hansench-bit/meshslide-dualrf/renders/2D_Fitment_Check_v2.0.png

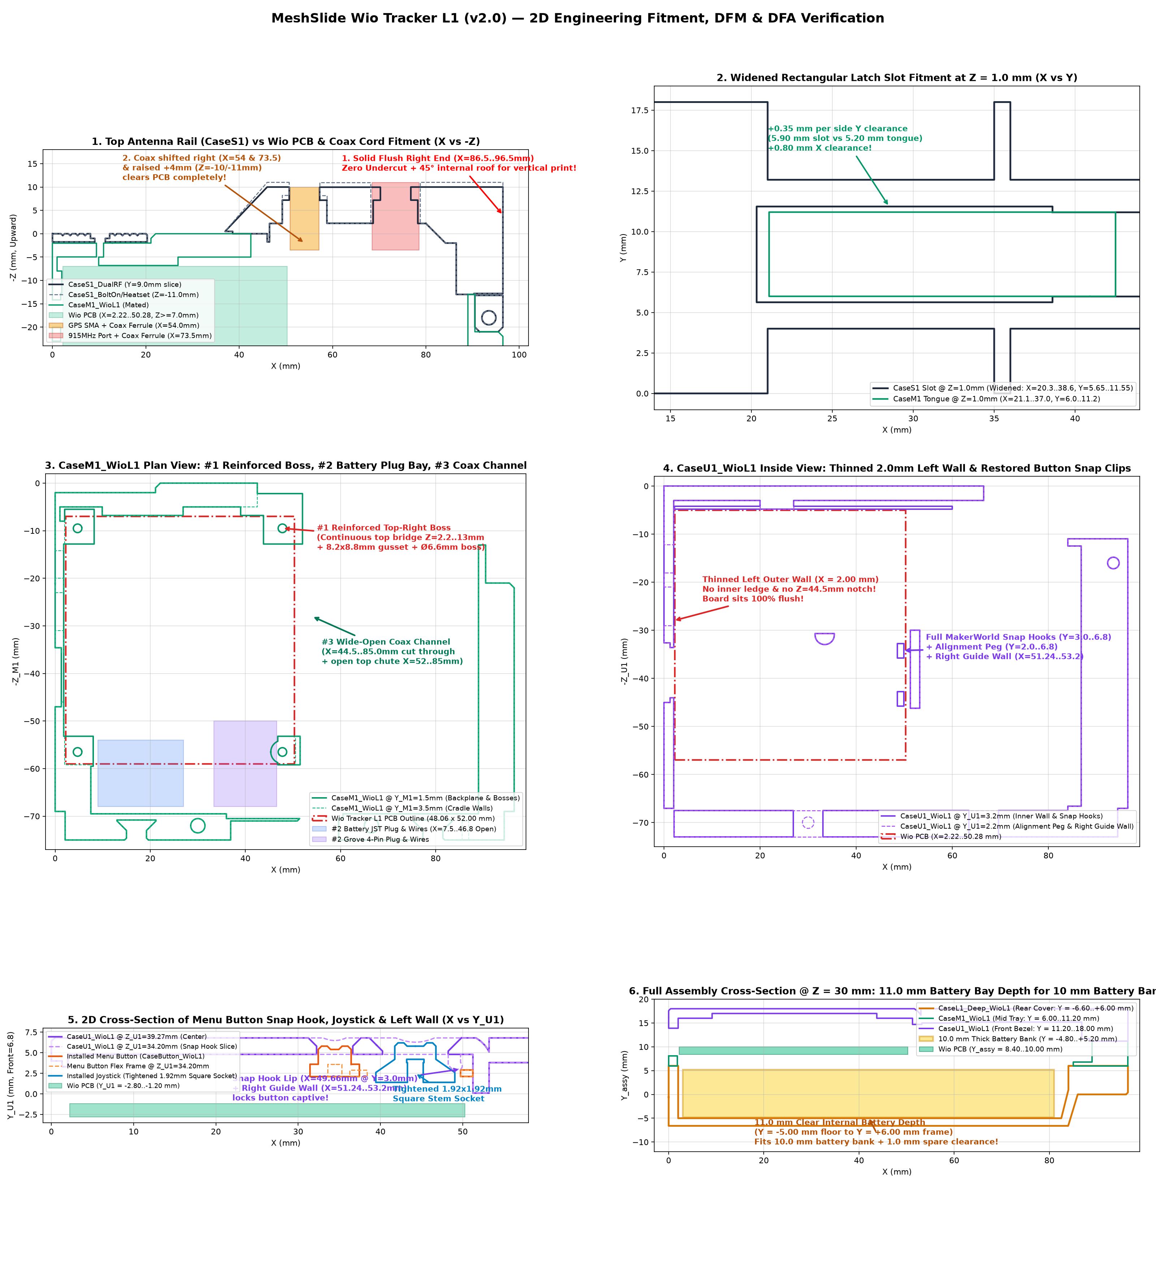
renders/2D_Fitment_Check_v2.0.png
