hansench-bit/meshslide-dualrf/renders/CaseS1_DualRF_BoltOn_Underside_Check.png

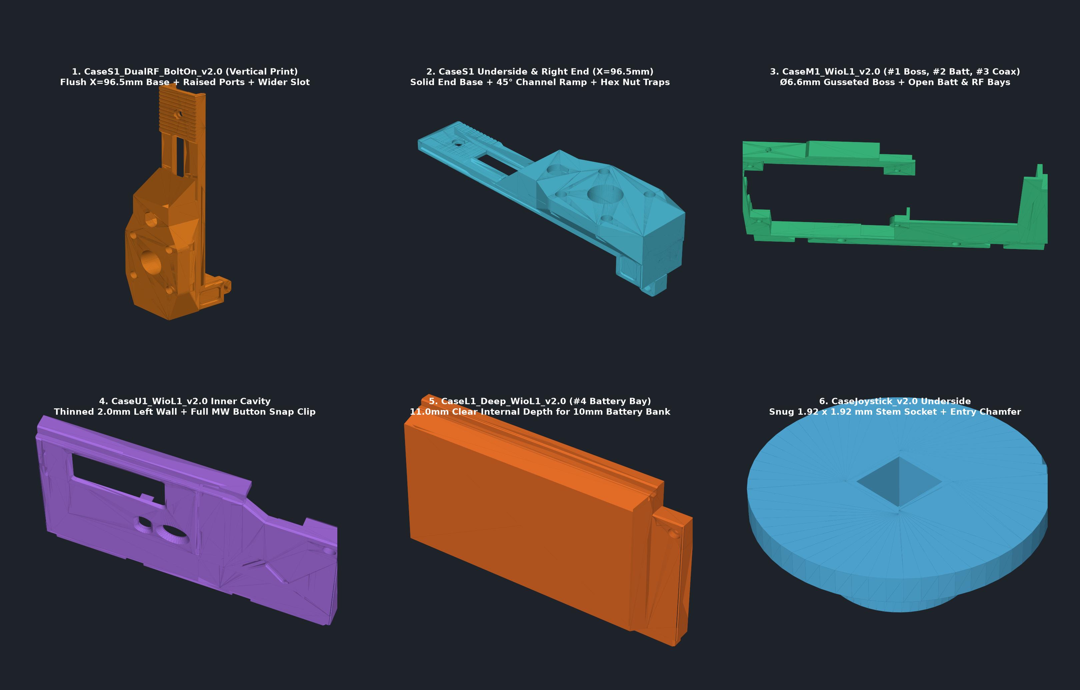
renders/CaseS1_DualRF_BoltOn_Underside_Check.png
