hansench-bit/meshslide-dualrf/renders/MeshSlide_DualRF_Blueprints.png

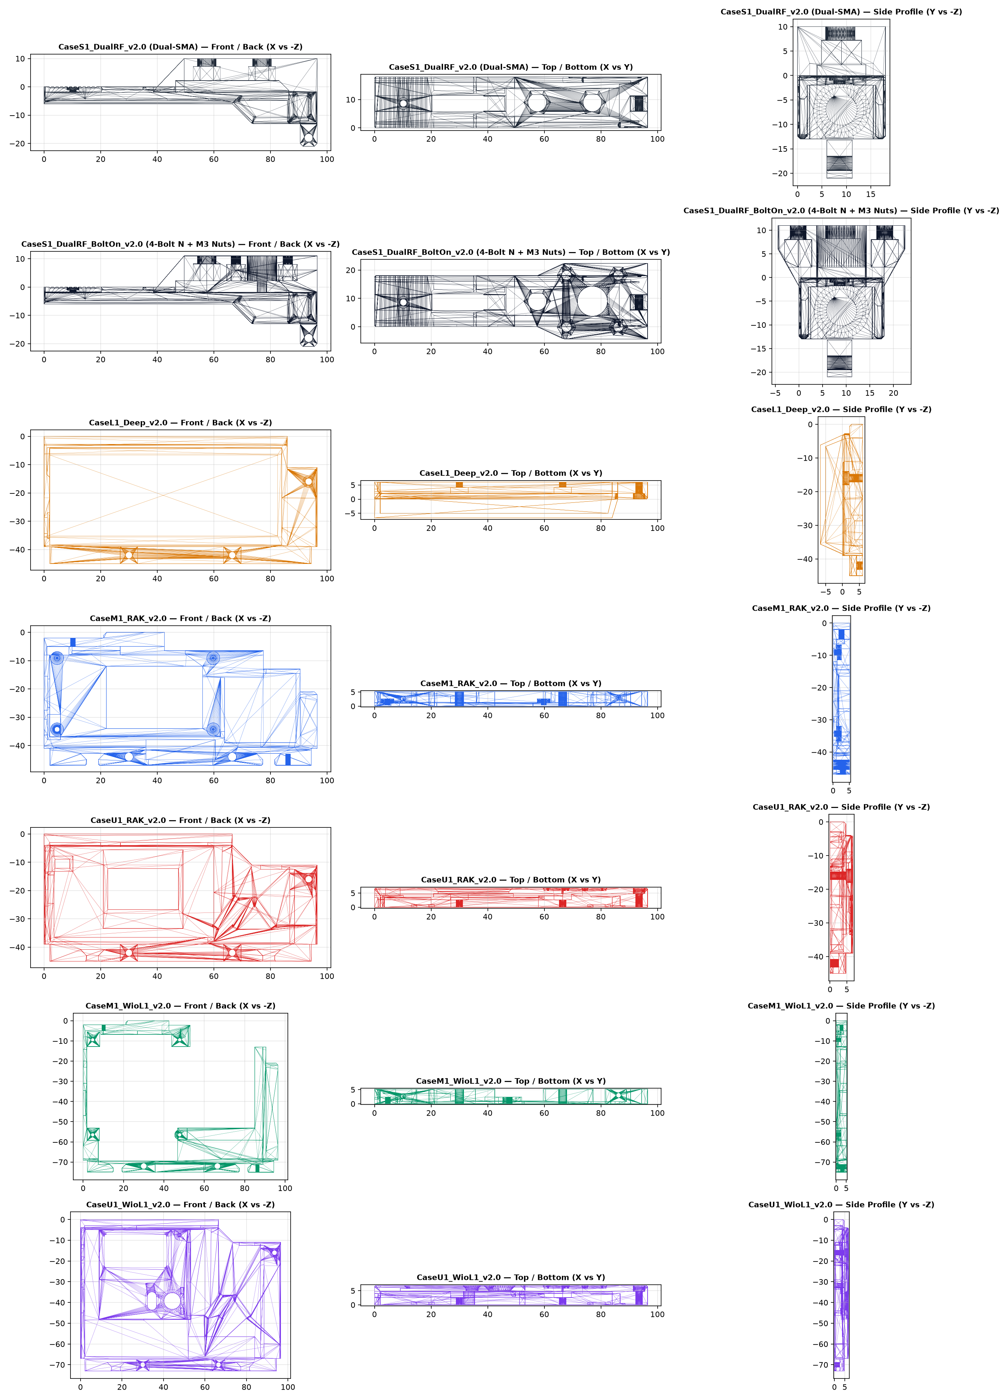
renders/MeshSlide_DualRF_Blueprints.png
