hansench-bit/meshslide-dualrf/renders/Top_Antenna_Rails_v2.0.png

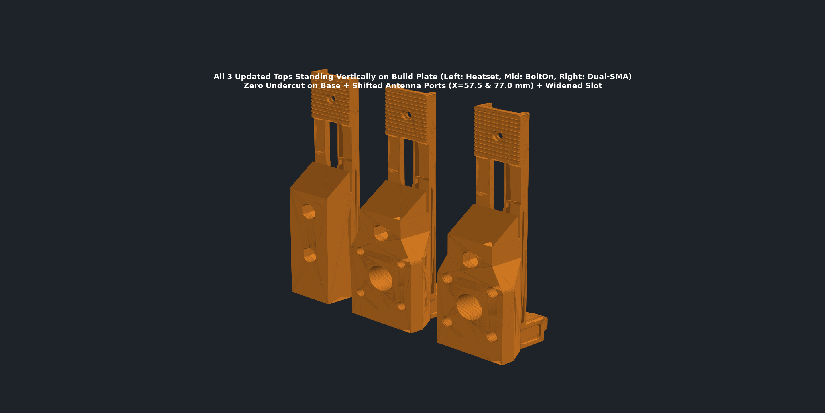
renders/Top_Antenna_Rails_v2.0.png
