hansench-bit/meshslide-dualrf/3MF/Wio_Tracker_L1_Complete_v2.0.3mf

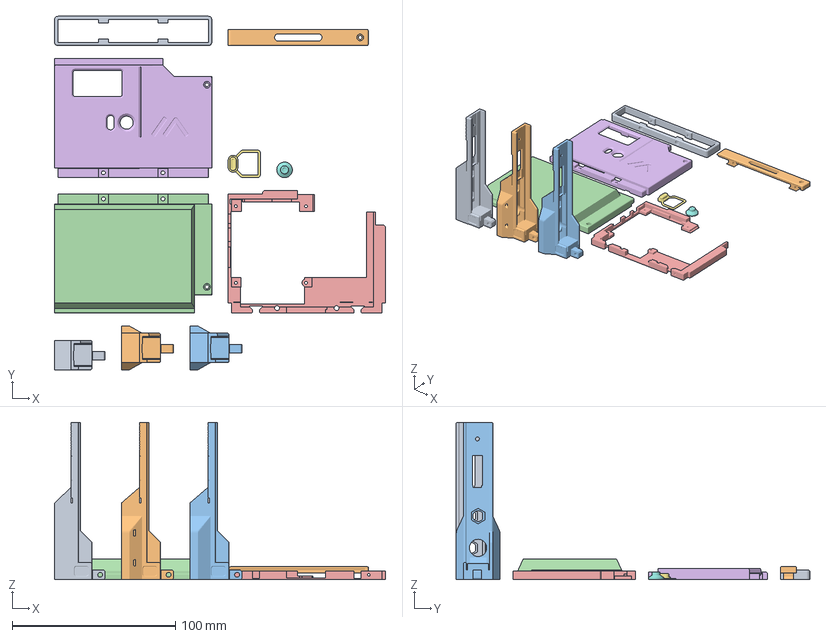
[picture p15: CAD file, 2026-11-10]
3MF/Wio_Tracker_L1_Complete_v2.0.3mf
203.0 x 216.8 x 96.5 mm
CaseS1_DualRF_v2.0
CaseS1_DualRF_BoltOn_v2.0
CaseS1_DualRF_Heatset_v2.0
CaseL1_Deep_WioL1_v2.0
CaseM1_WioL1_v2.0
CaseU1_WioL1_v2.0
CaseButton_WioL1_v2.0
CaseJoystick_v2.0
CaseR1_v2.0
CaseSlide_v2.0
