hansench-bit/meshslide-dualrf/reference_original/Wio_MW_Bezel_Patch.stl

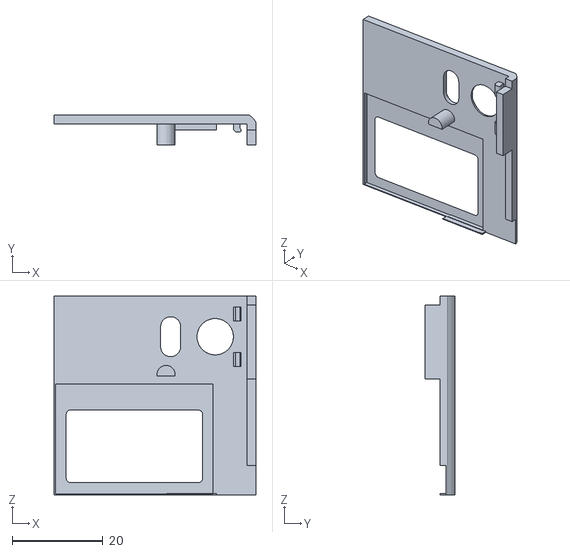
[picture p16: CAD file, 2026-11-10]
reference_original/Wio_MW_Bezel_Patch.stl
44.4 x 6.70 x 43.7
