hansench-bit/meshslide-dualrf/reference_original/CaseM1.STL

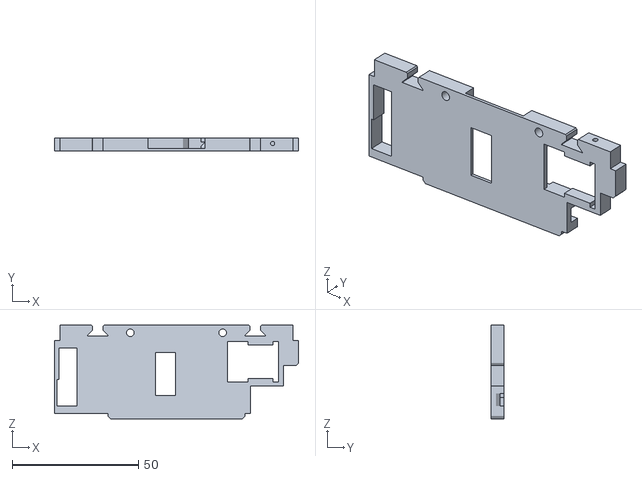
[picture p17: CAD file, 2026-11-09]
reference_original/CaseM1.STL
96.5 x 5.20 x 37.0
