hansench-bit/meshslide-dualrf/reference_original/CaseR1.STL

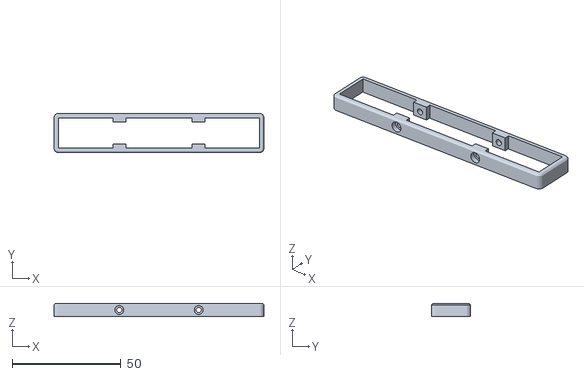
[picture p18: CAD file, 2026-11-09]
reference_original/CaseR1.STL
96.5 x 18.0 x 6.00
