hansench-bit/meshslide-dualrf/reference_original/KB_S3.STL

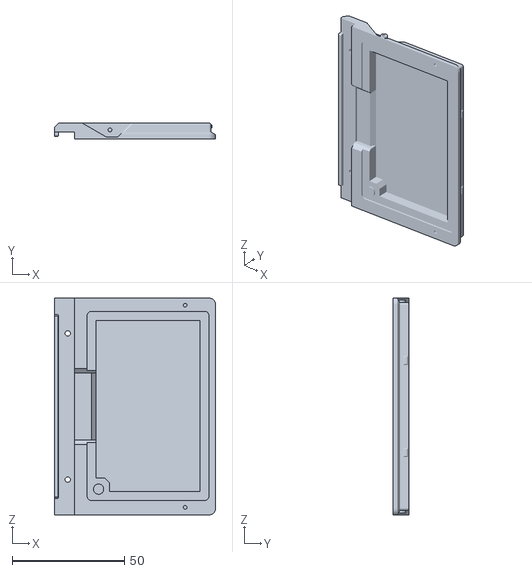
[picture p19: CAD file, 2026-11-09]
reference_original/KB_S3.STL
71.8 x 7.00 x 96.5
