hansench-bit/meshslide-dualrf/reference_original/Wio_MW_Menu_Button.stl

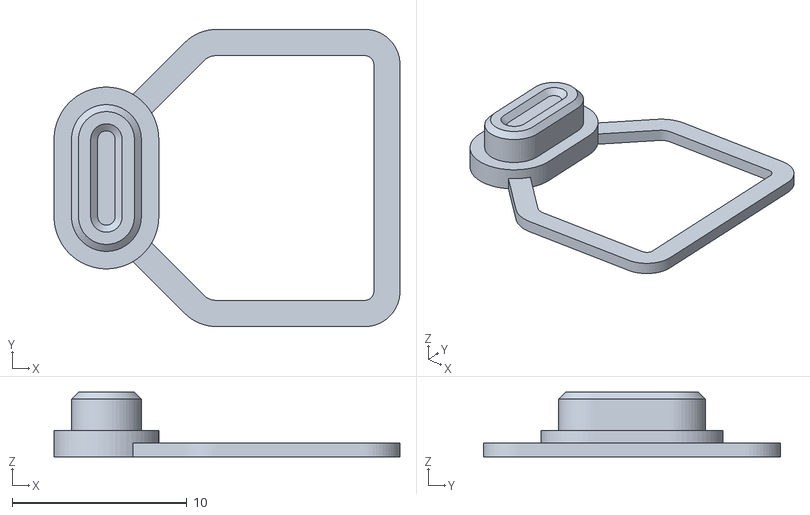
[picture p20: CAD file, 2026-11-09]
reference_original/Wio_MW_Menu_Button.stl
19.8 x 17.0 x 3.70
