hansench-bit/meshslide-dualrf/reference_original/Wio_MW_Joystick_Cap.stl

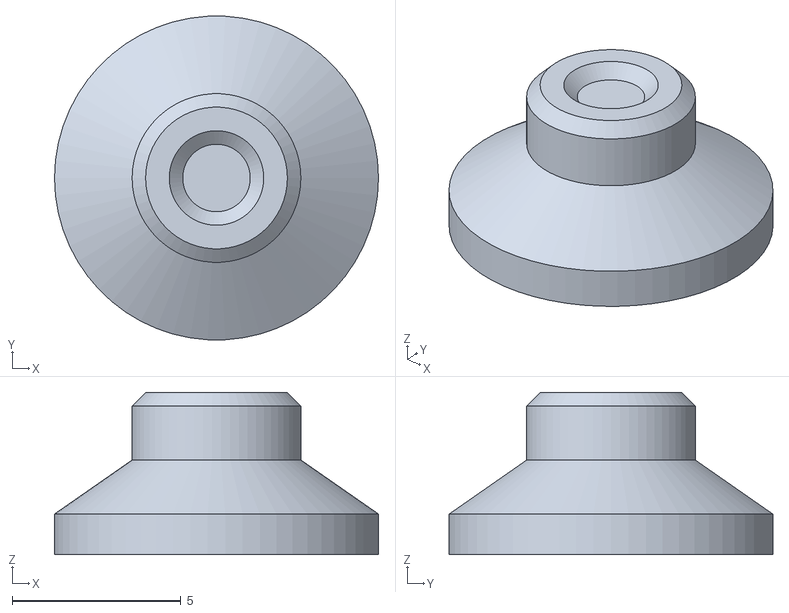
[picture p21: CAD file, 2026-11-09]
reference_original/Wio_MW_Joystick_Cap.stl
9.60 x 9.59 x 4.80
