hansench-bit/meshslide-dualrf/reference_original/KB_S1.STL

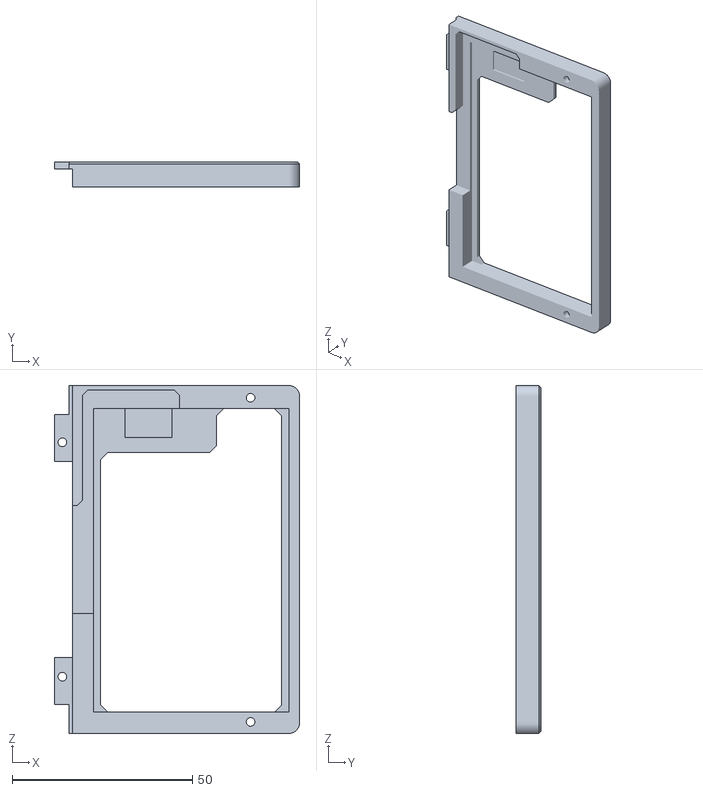
[picture p22: CAD file, 2026-11-09]
reference_original/KB_S1.STL
68.0 x 7.00 x 96.5
