hansench-bit/meshslide-dualrf/reference_original/CaseSlide.STL

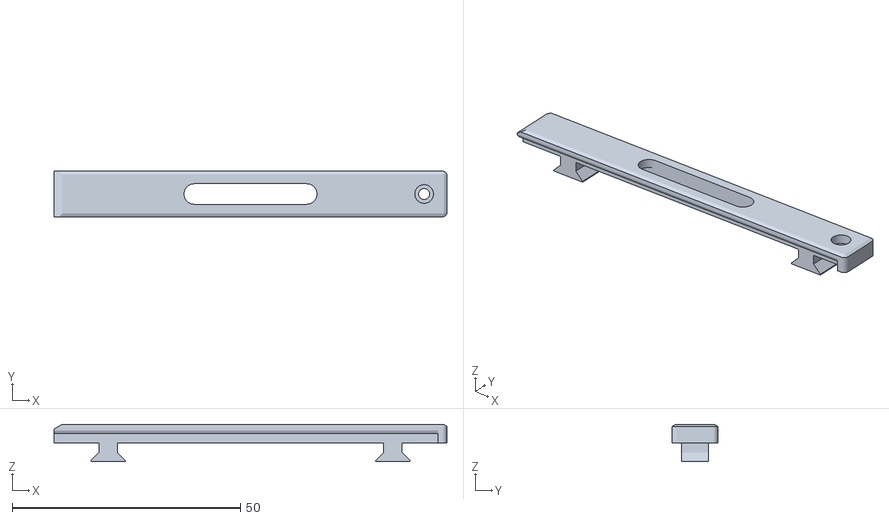
[picture p23: CAD file, 2026-11-09]
reference_original/CaseSlide.STL
86.0 x 10.0 x 8.10
