hansench-bit/meshslide-dualrf/reference_original/CaseL1.STL

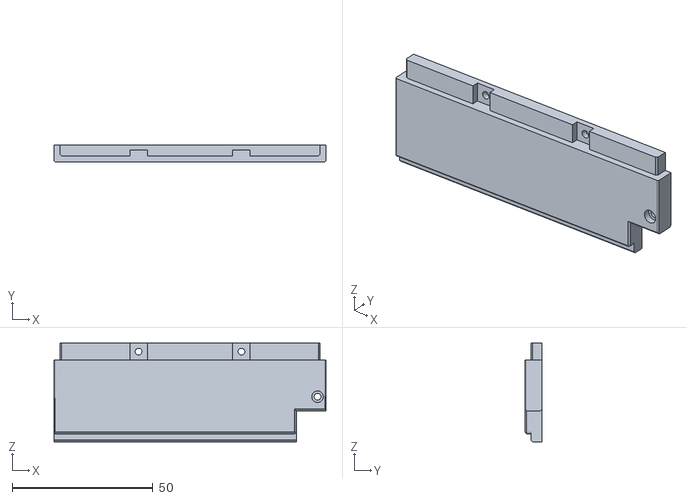
[picture p24: CAD file, 2026-11-09]
reference_original/CaseL1.STL
96.5 x 6.00 x 35.0
