hansench-bit/meshslide-dualrf/reference_original/CaseS1.STL

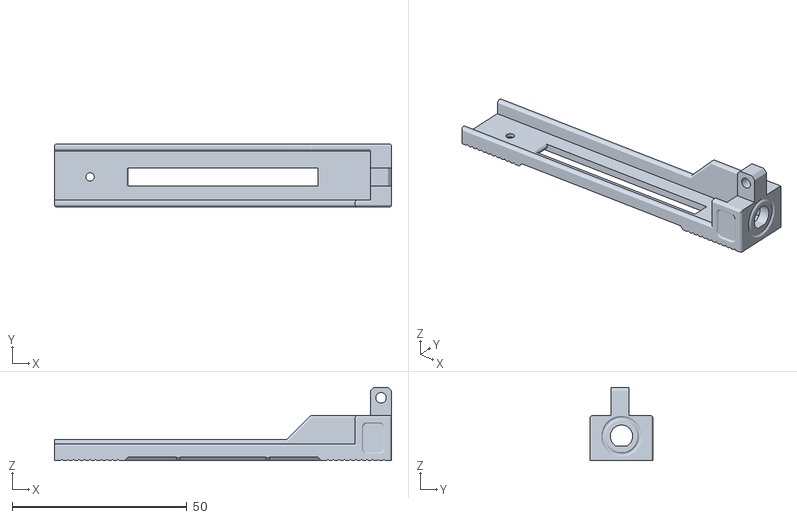
[picture p25: CAD file, 2026-11-09]
reference_original/CaseS1.STL
96.5 x 18.0 x 21.0
