hansench-bit/meshslide-dualrf/reference_original/CaseU1.STL

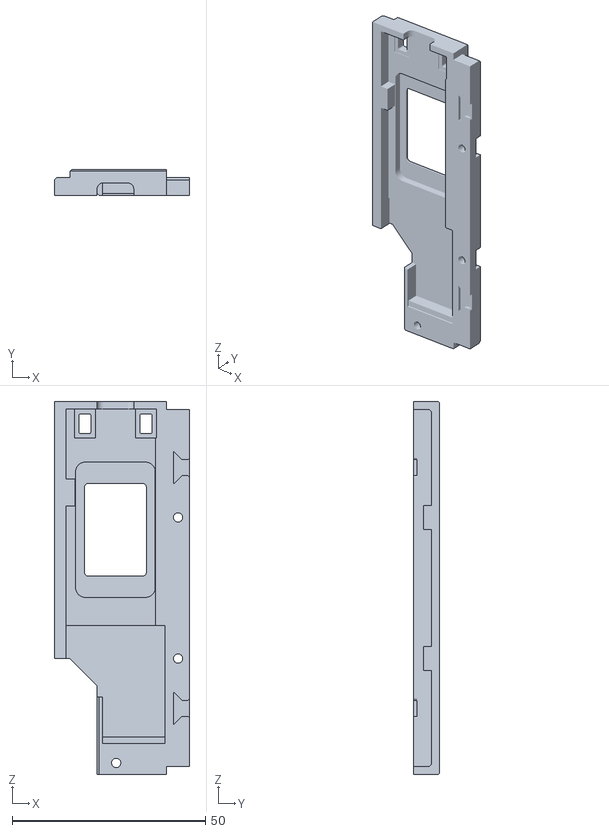
[picture p26: CAD file, 2026-11-09]
reference_original/CaseU1.STL
35.0 x 6.80 x 96.5
