hansench-bit/meshslide-dualrf/reference_original/CaseButton.STL

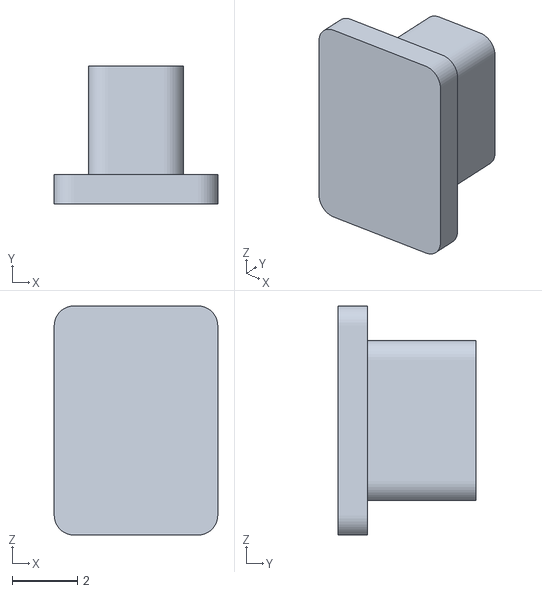
[picture p27: CAD file, 2026-11-09]
reference_original/CaseButton.STL
5.00 x 4.22 x 7.00
