hansench-bit/meshslide-dualrf/(list of files, cad)

Other CAD files:
STEP/CardKB_Pro_v2.0/KB_Button_Single_Main_v2.0.step
STEP/RAK_WisBlock_v2.0/CaseM1_RAK_v2.0.step
STEP/Wio_Tracker_L1_v2.0/CaseM1_WioL1_v2.0.step
STEP/CardKB_Pro_v2.0/KB_S1_Pro_v2.0.step
STEP/RAK_WisBlock_v2.0/CaseS1_DualRF_Heatset_v2.0.step
STEP/Wio_Tracker_L1_v2.0/CaseS1_DualRF_v2.0.step
STEP/CardKB_Pro_v2.0/CardKB_Standalone_Bezel_v2.0.step
STEP/Wio_Tracker_L1_v2.0/CaseS1_DualRF_Heatset_v2.0.step
STEP/CardKB_Pro_v2.0/KB_Buttons_Loose_Set_v2.0.step
STEP/RAK_WisBlock_v2.0/CaseS1_DualRF_v2.0.step
STEP/CardKB_Pro_v2.0/KB_S3_Pro_v2.0.step
STEP/RAK_WisBlock_v2.0/CaseL1_Deep_v2.0.step
STEP/Wio_Tracker_L1_v2.0/CaseL1_Deep_WioL1_v2.0.step
STEP/CardKB_Pro_v2.0/KB_Bezel_Legends_AMS_v2.0.step
STEP/RAK_WisBlock_v2.0/CaseButton_v2.0.step
STEP/Wio_Tracker_L1_v2.0/CaseJoystick_v2.0.step
STEP/CardKB_Pro_v2.0/KB_Buttons_Bridged_Tray_v2.0.step
STEP/RAK_WisBlock_v2.0/CaseU1_RAK_v2.0.step
STEP/Wio_Tracker_L1_v2.0/CaseU1_WioL1_v2.0.step
STEP/CardKB_Pro_v2.0/CardKB_Standalone_Back_v2.0.step
STEP/RAK_WisBlock_v2.0/CaseSlide_v2.0.step
STEP/Wio_Tracker_L1_v2.0/CaseButton_WioL1_v2.0.step
STEP/CardKB_Pro_v2.0/KB_TPU_Mat_v2.0.step
STEP/RAK_WisBlock_v2.0/CaseR1_v2.0.step
STEP/Wio_Tracker_L1_v2.0/CaseSlide_v2.0.step
STEP/Wio_Tracker_L1_v2.0/CaseR1_v2.0.step
STEP/RAK_WisBlock_v2.0/CaseS1_DualRF_BoltOn_v2.0.step
STEP/Wio_Tracker_L1_v2.0/CaseS1_DualRF_BoltOn_v2.0.step
STL/CardKB_Pro_v2.0/CardKB_Standalone_Back_v2.0.stl
STL/CardKB_Pro_v2.0/CardKB_Standalone_Bezel_v2.0.stl
STL/CardKB_Pro_v2.0/KB_Bezel_Legends_AMS_v2.0.stl
STL/CardKB_Pro_v2.0/KB_Button_Single_Main_v2.0.stl
STL/CardKB_Pro_v2.0/KB_Buttons_Bridged_Tray_v2.0.stl
STL/CardKB_Pro_v2.0/KB_Buttons_Loose_Set_v2.0.stl
STL/CardKB_Pro_v2.0/KB_S1_Pro_v2.0.stl
STL/CardKB_Pro_v2.0/KB_S3_Pro_v2.0.stl
STL/CardKB_Pro_v2.0/KB_TPU_Mat_v2.0.stl
STL/RAK_WisBlock_v2.0/CaseButton_v2.0.stl
STL/RAK_WisBlock_v2.0/CaseL1_Deep_v2.0.stl
STL/RAK_WisBlock_v2.0/CaseM1_RAK_v2.0.stl
STL/RAK_WisBlock_v2.0/CaseR1_v2.0.stl
STL/RAK_WisBlock_v2.0/CaseS1_DualRF_BoltOn_v2.0.stl
STL/RAK_WisBlock_v2.0/CaseS1_DualRF_Heatset_v2.0.stl
STL/RAK_WisBlock_v2.0/CaseS1_DualRF_v2.0.stl
STL/RAK_WisBlock_v2.0/CaseSlide_v2.0.stl
STL/RAK_WisBlock_v2.0/CaseU1_RAK_v2.0.stl
STL/Wio_Tracker_L1_v2.0/CaseButton_WioL1_v2.0.stl
STL/Wio_Tracker_L1_v2.0/CaseJoystick_v2.0.stl
STL/Wio_Tracker_L1_v2.0/CaseL1_Deep_WioL1_v2.0.stl
STL/Wio_Tracker_L1_v2.0/CaseM1_WioL1_v2.0.stl
STL/Wio_Tracker_L1_v2.0/CaseR1_v2.0.stl
STL/Wio_Tracker_L1_v2.0/CaseS1_DualRF_BoltOn_v2.0.stl
STL/Wio_Tracker_L1_v2.0/CaseS1_DualRF_Heatset_v2.0.stl
STL/Wio_Tracker_L1_v2.0/CaseS1_DualRF_v2.0.stl
STL/Wio_Tracker_L1_v2.0/CaseSlide_v2.0.stl
STL/Wio_Tracker_L1_v2.0/CaseU1_WioL1_v2.0.stl
