hansench-bit/meshslide-dualrf/(commit log)

2026-11-09 Release v2.0: Wio Tracker L1 & RAK19007 enclosures with Dual-SMA, Captive M3 Nut N-Type, and Heat-Set Insert N-Type top rails
    [CardKB_Pro_Hybrid_Kit_v2.0.3mf, CardKB_Standalone_Back_v2.0.step, CardKB_Standalone_Back_v2.0.stl, CardKB_Standalone_Bezel_v2.0.step, CardKB_Standalone_Bezel_v2.0.stl, CaseButton.STL, CaseButton_WioL1_v2.0.step, CaseButton_WioL1_v2.0.stl]
2026-11-10 Apply v2.0 fitment, DFM, and DFA fixes across CaseS1, CaseM1, CaseU1, CaseL1_Deep, and CaseJoystick
    [CardKB_Pro_Hybrid_Kit_v2.0.3mf, CaseJoystick_v2.0.step, CaseJoystick_v2.0.stl, CaseL1_Deep_WioL1_v2.0.step, CaseL1_Deep_WioL1_v2.0.stl, CaseL1_Deep_v2.0.step, CaseL1_Deep_v2.0.stl, CaseM1_WioL1_v2.0.step]
2026-11-10 Update all 3D part and assembly renders for v2.0
2026-11-10 Consolidate to single Wio_Tracker_L1_Complete_v2.0.3mf, remove archive/old 3MFs, and extend N-Type flange flush to X=96.5mm build plate
    [CardKB_Pro_Hybrid_Kit_v2.0.3mf, CaseS1_DualRF_BoltOn_v2.0.step, CaseS1_DualRF_BoltOn_v2.0.stl, CaseS1_DualRF_Heatset_v2.0.step, CaseS1_DualRF_Heatset_v2.0.stl, CaseS1_DualRF_v2.0.step, CaseS1_DualRF_v2.0.stl, MeshSlide_RAK19007_Kit_v2.0.3mf]
2026-11-10 Remove bottom standing wall on CaseM1_WioL1 and pre-orient Y=0 flat on build plate in 3MF
    [CaseM1_RAK_v2.0.step, CaseM1_RAK_v2.0.stl, CaseM1_WioL1_v2.0.step, CaseM1_WioL1_v2.0.stl, Wio_Tracker_L1_Complete_v2.0.3mf]
